maynej/Ulleres-de-colors/README.md

# Ulleres-de-colors
Es tracta construir unes ulleres amb impressió 3D, que munten LEDs Neopixels i es poden generar centenars de combinacions de llum.  

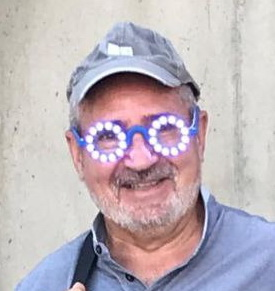
[picture p1: Imatges/Ulleres.jpg]
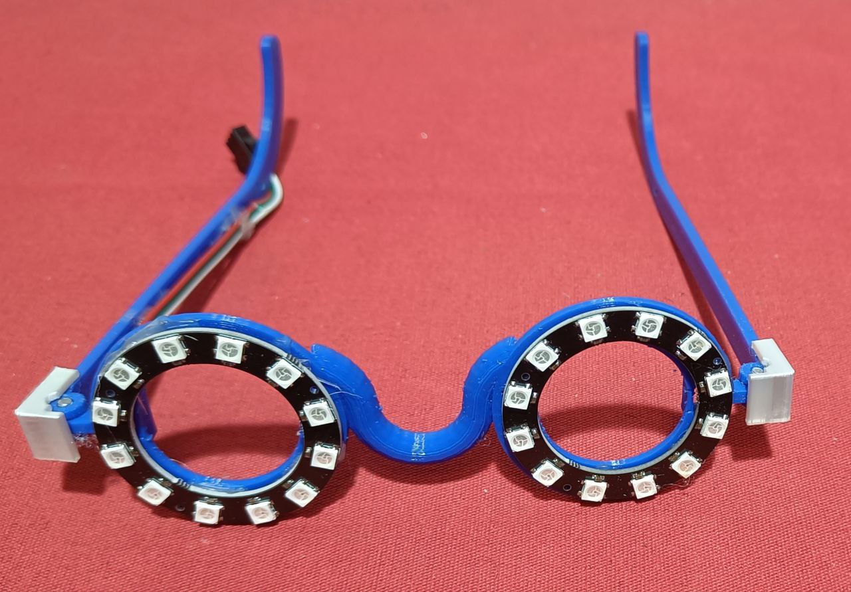
[picture p2: Imatges/UlleresM.jpg]
       

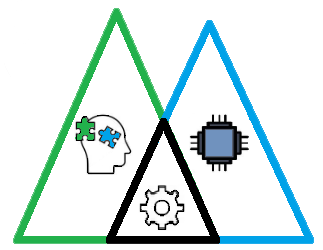
[picture p3: Imatges/Logo3senseFons.png]
Realitzat per [Jordi Mayné](https://github.com/maynej) des de Mechatronic Study jordi.mayne@mechatronicstudy.com 

La documentació està disponible [en PDF](https://github.com/maynej/Ulleres-de-colors/tree/main/Doc/). També en castellà.

# Arxius per imprimir 
  
Descripció         | Imatge          | Arxiu STL    
------------- | ------------- | ------------- 
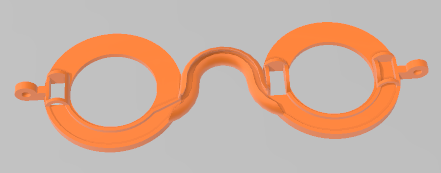
[picture p4: Imatges/Ulleres.png]
Ulleres | | [Ulleres](STL/Ulleres.stl)
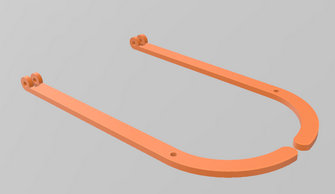
[picture p5: Imatges/Varetes.png]
Varetes | | [Varetes](STL/Varetes.stl)
Clip Esquerra | | [Clip E](STL/ClipE.stl)
Clip Dret | | [Clip D](STL/ClipD.stl)

Creative Commons Attribution-NoComercial-ShareAlike 4.0 International (CC BY-NC-SA 4.0)  

## QR
