maynej/Ulleres-de-colors/STL/ClipD.stl

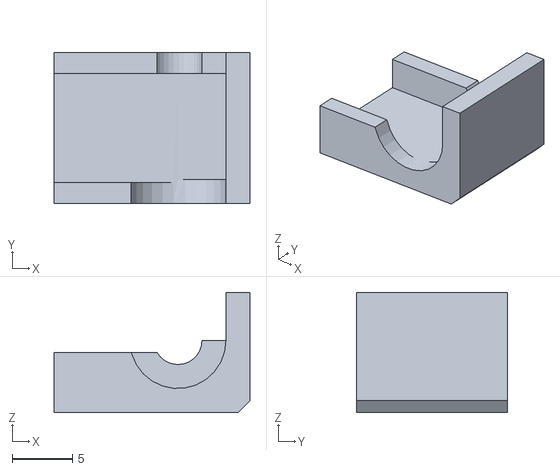
[picture p38: CAD file, 2025-01-12]
STL/ClipD.stl
16.3 x 12.6 x 10.0
