maynej/Ulleres-de-colors/STL/Ulleres_Jordi.stl

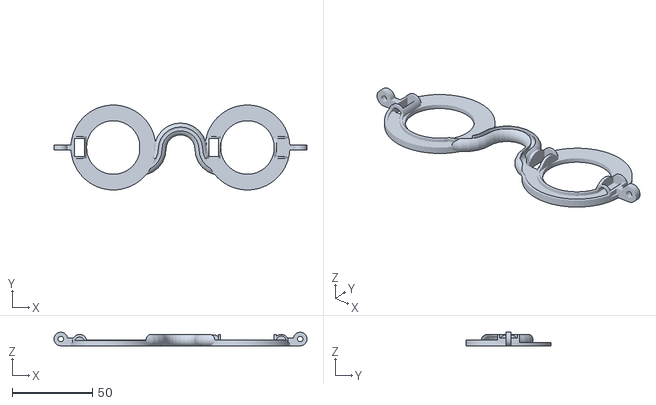
[picture p39: CAD file, 2025-01-12]
STL/Ulleres_Jordi.stl
157.2 x 52.8 x 8.44
