maynej/Ulleres-de-colors/STL/Varetes.stl

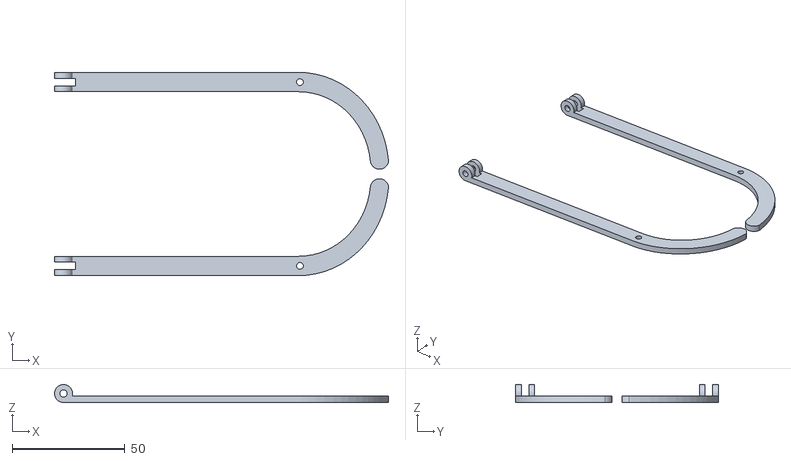
[picture p40: CAD file, 2024-09-14]
STL/Varetes.stl
147.9 x 90.0 x 8.00
