maynej/Ulleres-de-colors/(list of files, cad)

Other CAD files:
STL/ClipE.stl
